tudsat-rocket/sting/README.md

EURoC Flight Computer
=====================

# Setup

Requires KiCAD version >= 6.0. To generate BOM, install the Interactive HTML BOM plugin: https://github.com/openscopeproject/InteractiveHtmlBom
