tudsat-rocket/sting/3dmodels/sma.step

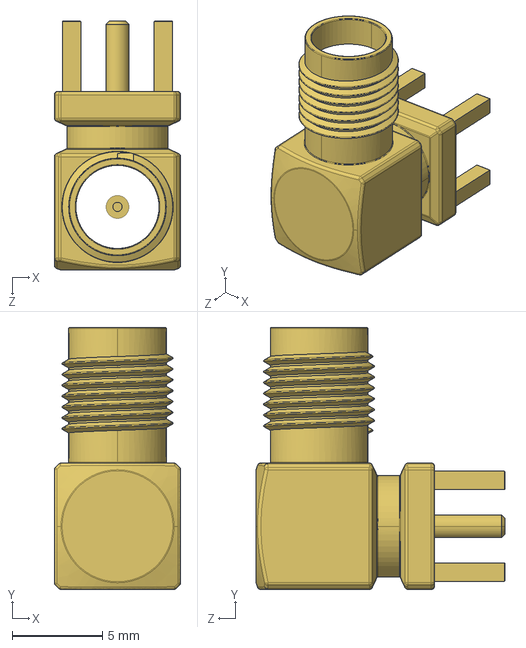
[picture p1: CAD file, 2023-01-26]
3dmodels/sma.step
7.00 x 14.5 x 13.8 mm
