tudsat-rocket/sting/3dmodels/sam_m8q.step

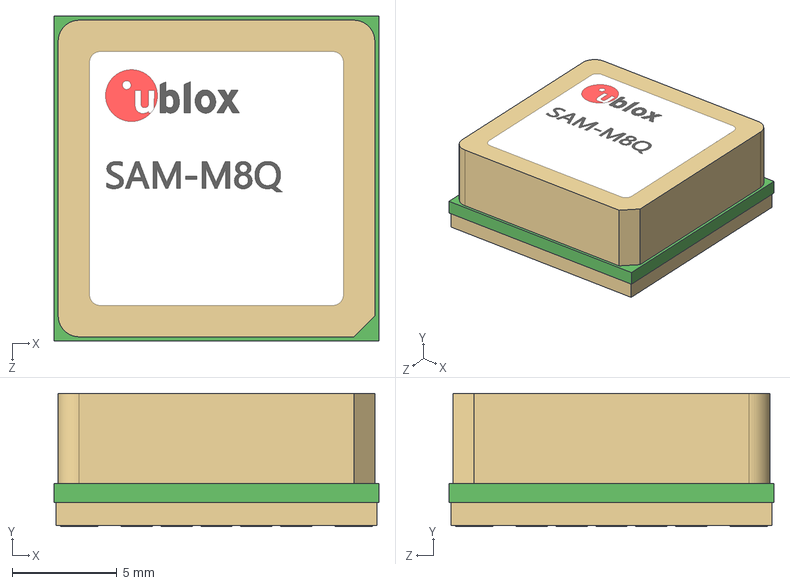
[picture p2: CAD file, 2023-01-26]
3dmodels/sam_m8q.step
15.5 x 6.35 x 15.5 mm
