tudsat-rocket/sting/3dmodels/usb_c.step

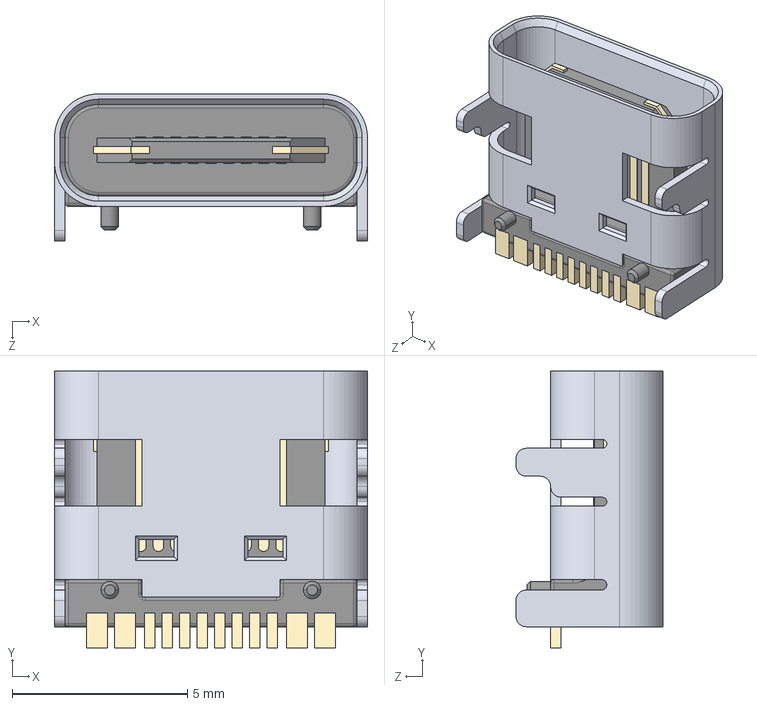
[picture p3: CAD file, 2022-07-26]
3dmodels/usb_c.step
8.94 x 7.90 x 4.20 mm
