tudsat-rocket/sting/3dmodels/ra_02.step

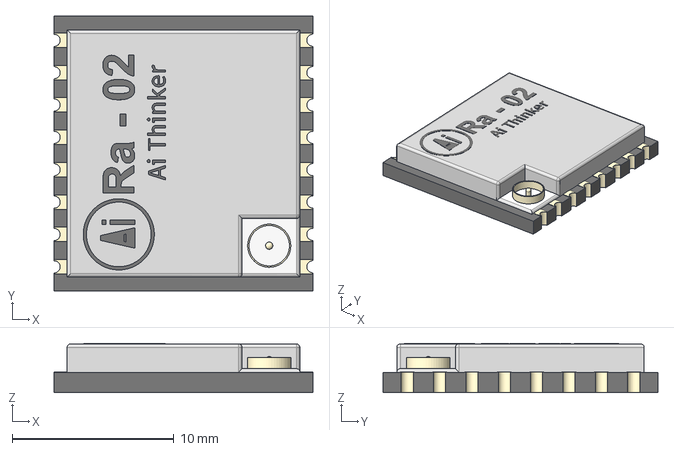
[picture p4: CAD file, 2022-07-01]
3dmodels/ra_02.step
16.0 x 17.0 x 3.03 mm
