tudsat-rocket/sting/3dmodels/EVQ-PUC02K.step

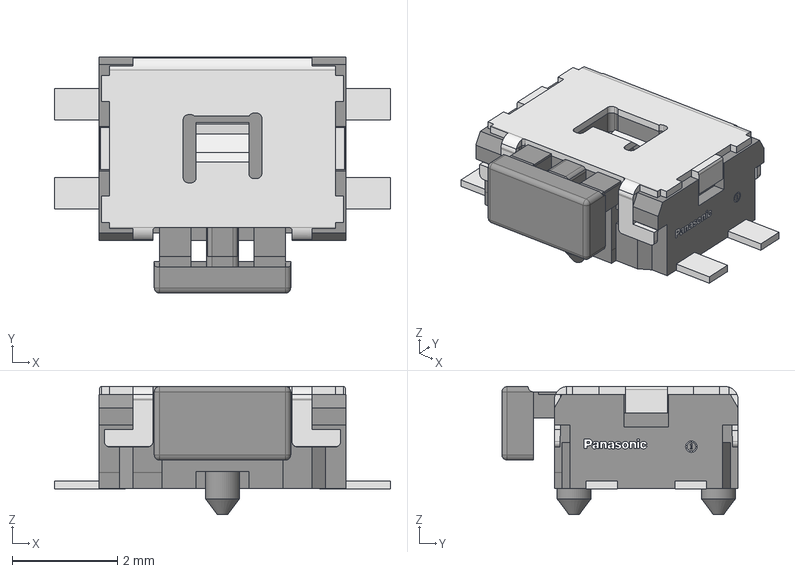
[picture p5: CAD file, 2022-07-01]
3dmodels/EVQ-PUC02K.step
6.40 x 4.50 x 2.44 mm
