tudsat-rocket/sting/3dmodels/430450400.step

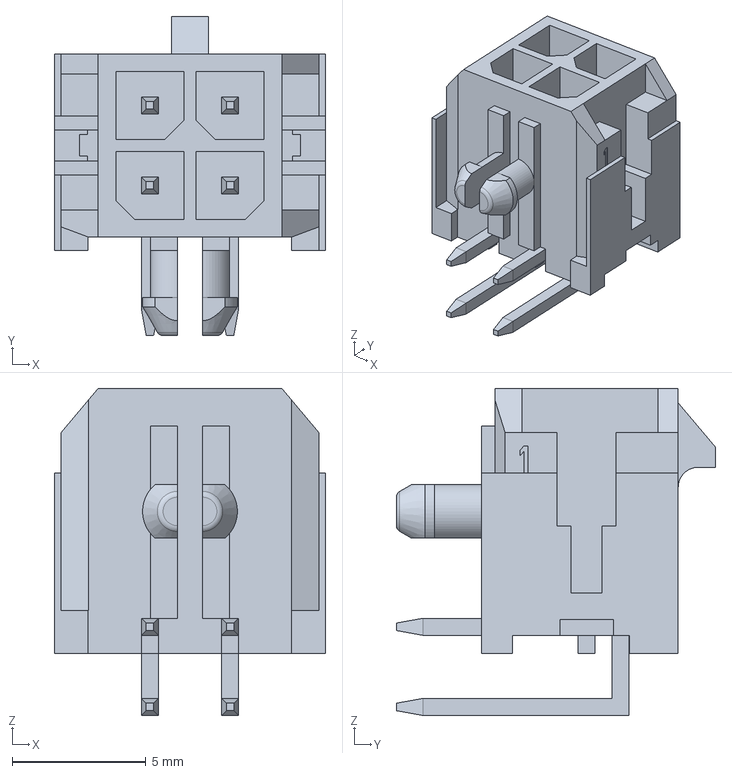
[picture p6: CAD file, 2023-01-26]
3dmodels/430450400.step
10.2 x 11.9 x 12.2 mm
