tudsat-rocket/sting/euroc_fc.kicad_pcb

## KiCad design euroc_fc.kicad_pcb (2023-02-13)

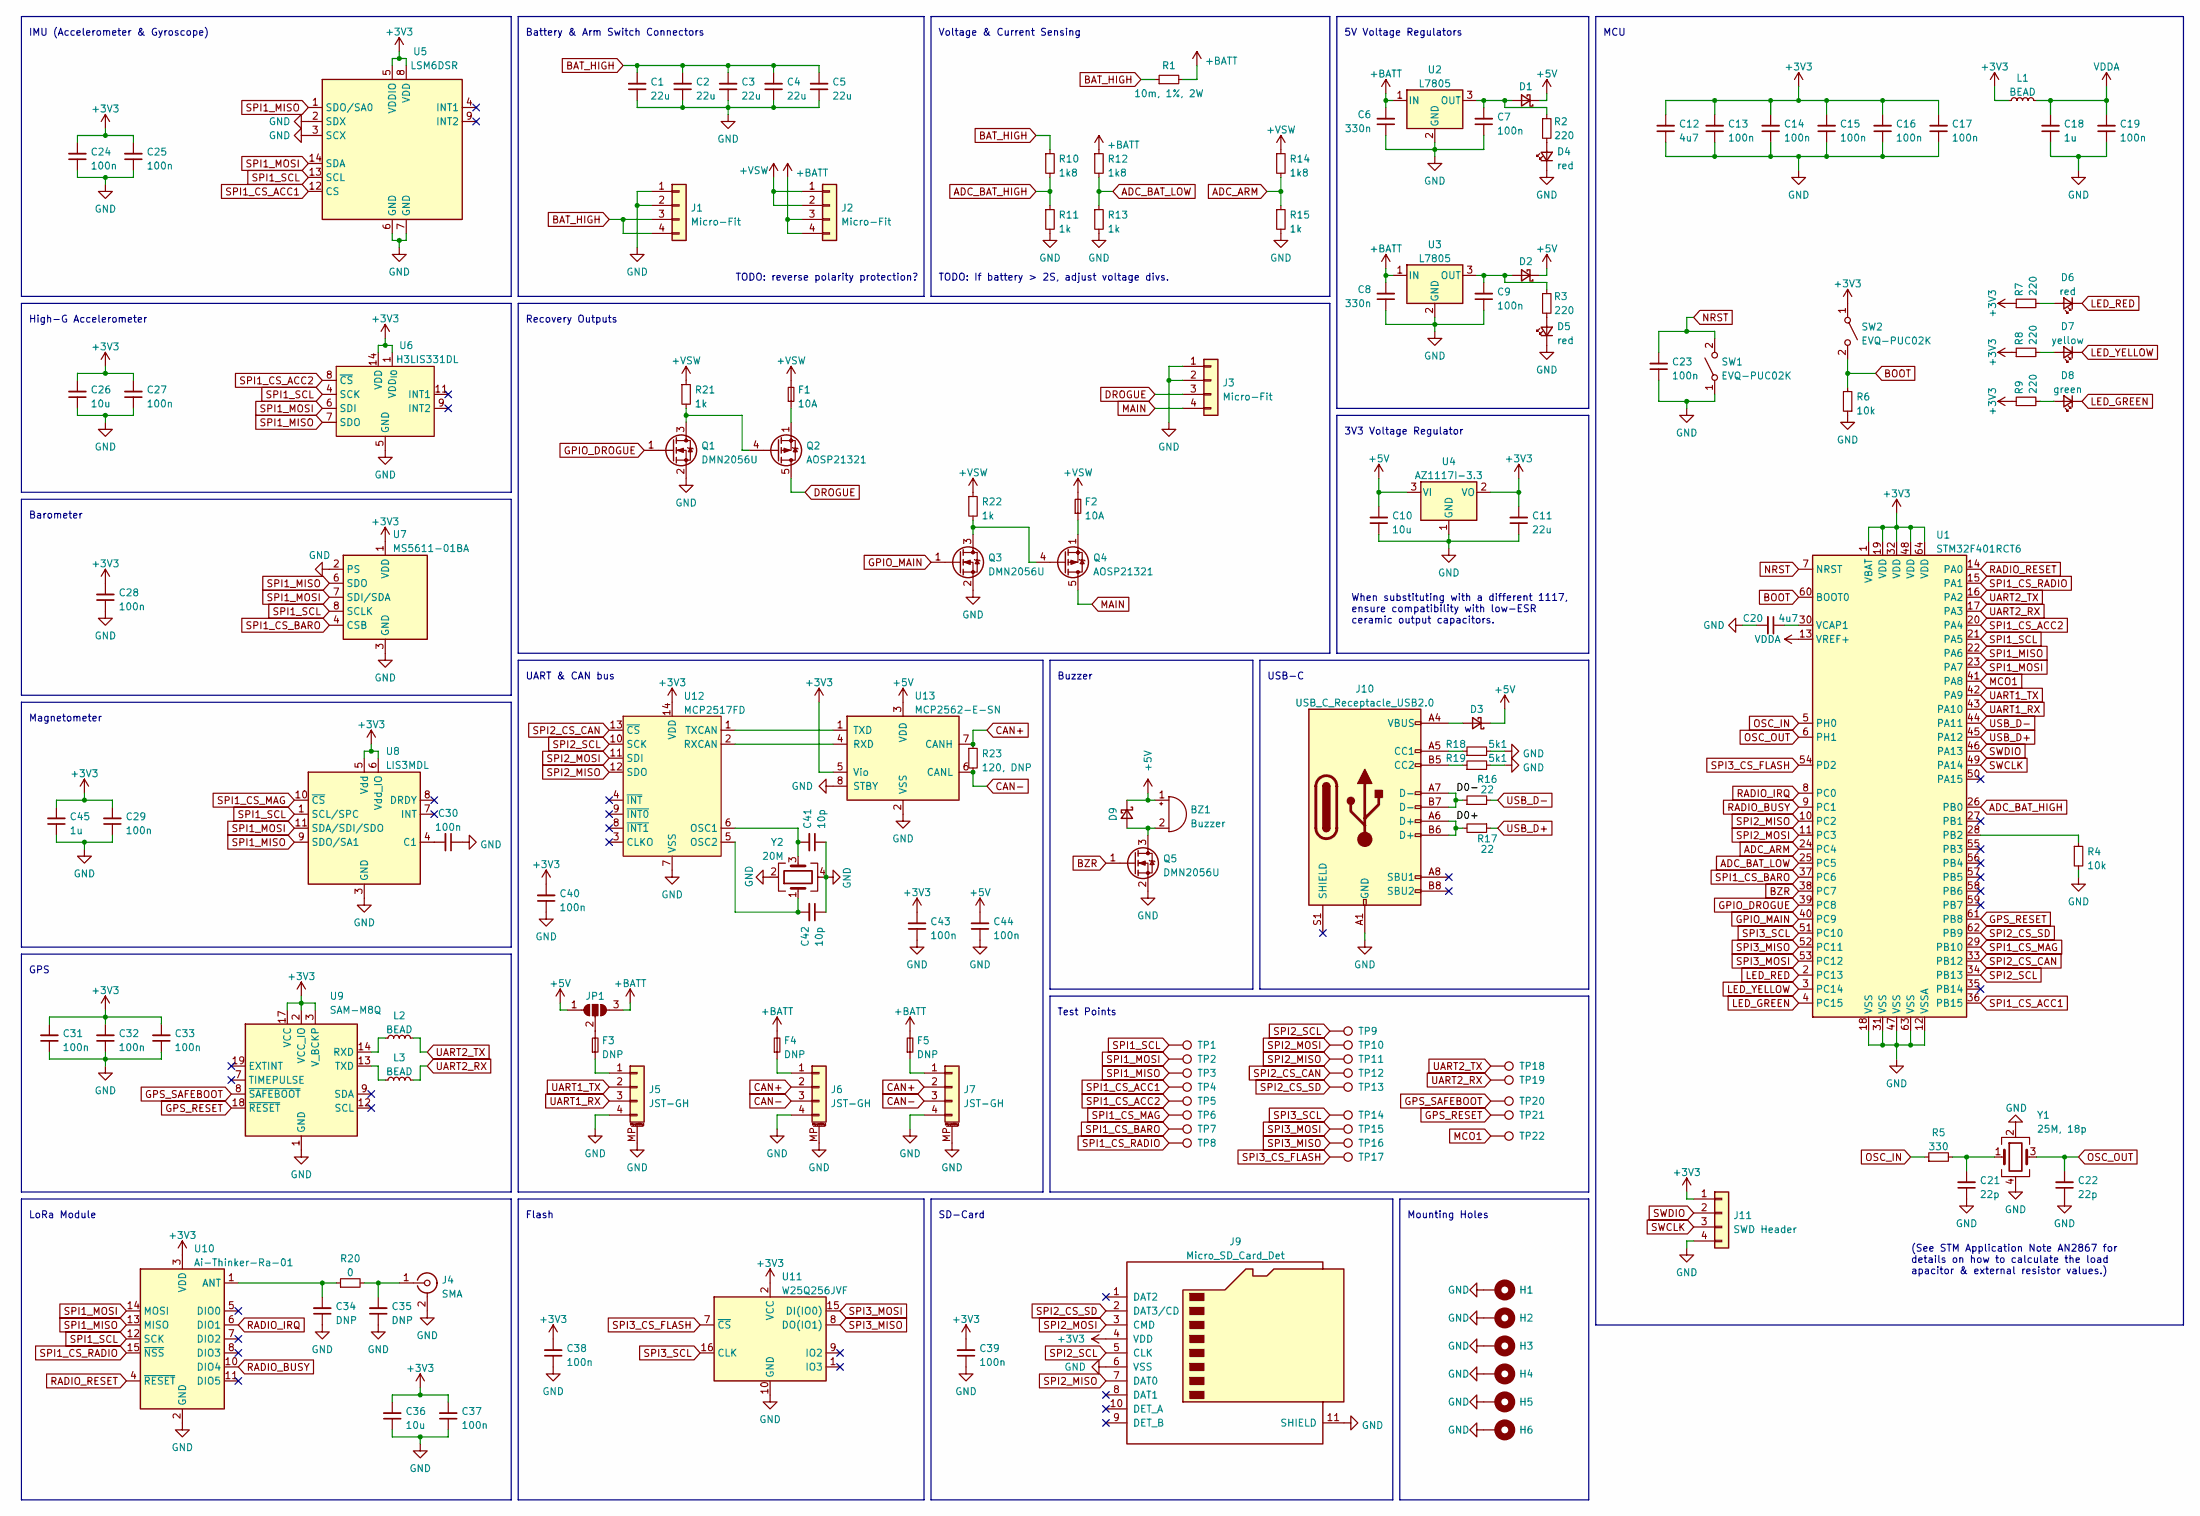
[picture p7: schematic euroc_fc.kicad_sch]

Parts:
BZ1: Buzzer; MagneticBuzzer_CUI_CMT-8504-100-SMT; Part# CMT-8504-100-SMT-TR; DigiKey# 102-CMT-8504-100-SMT-CT-ND
C1, C2, C3, C4, C5, C11: 22u; C_1206_3216Metric; Part# CL31A226KAHNNNE; LCSC# C12891
C6, C8: 330n; C_0603_1608Metric; Part# CL10B334KO8NNNC; LCSC# C159798
C7, C9, C13, C14, C15, C16, C17, C19, C23, C24, C25, C27, C28, C29, C30, C31, C32, C33, C37, C38, C39, C40, C43, C44: 100n; C_0603_1608Metric; Part# CL10B104KB8NNNC; LCSC# C1591
C10, C26, C36: 10u; C_1206_3216Metric; Part# CL31B106KAHNNNE; LCSC# C14860
C12, C20: 4u7; C_1206_3216Metric; Part# CL31B475KAHNNNE; LCSC# C1872
C18, C45: 1u; C_0805_2012Metric; Part# CL21A105KBCLNNC; LCSC# C318694
C21, C22: 22p; C_0603_1608Metric; Part# CL10C220JB8NNNC; LCSC# C1653
C34, C35: DNP; C_0603_1608Metric; Part# N/A; DigiKey# N/A
C41, C42: 10p; C_0603_1608Metric; Part# CL10C100JB8NNNC; LCSC# C1634
D1, D2, D3, D9: D_SOD-123F; Part# PMEG3020EH,115; LCSC# C167645
D4, D5, D6: red; LED_0603_1608Metric; Part# 19-213/RSC-BS2T2B/3T; LCSC# C474026
D7: yellow; LED_0603_1608Metric; Part# 19-213/Y2C-CQ2R2L/3T(CY); LCSC# C72038
D8: green; LED_0603_1608Metric; Part# 19-217/GHC-YR1S2/3T; LCSC# C72043
F1, F2: 10A; Fuse_1206_3216Metric; Part# 0501010.WR1; LCSC# C207003
F3, F4, F5: DNP; Fuse_1206_3216Metric; Part# N/A; DigiKey# N/A
H1, H2, H3, H4, H5, H6: MountingHole_Pad; MountingHole_3.2mm_M3_Pad_Via; Part# N/A; DigiKey# N/A
J1, J2, J3: Micro-Fit; Molex_Micro-Fit_3.0_43045-0400_2x02_P3.00mm_Horizontal; Part# 0430450400; LCSC# C122413
J4: SMA; SMA_Amphenol_901-143_Horizontal; Part# KH-SMA-K513-G; LCSC# C411575
J5, J6, J7: JST-GH; JST_GH_SM04B-GHS-TB_1x04-1MP_P1.25mm_Horizontal; Part# SM04B-GHS-TB; LCSC# C189895
J9: Micro_SD_Card_Det; microSD_HC_Hirose_DM3AT-SF-PEJM5; Part# DM3AT-SF-PEJM5; LCSC# C114218
J10: USB_C_Receptacle_USB2.0; USB_C_Receptacle_Palconn_UTC16-G; Part# KH-TYPE-C-16P; LCSC# C709357
J11: SWD Header; PinHeader_1x04_P2.54mm_Vertical
JP1: SolderJumper_3_Open; SolderJumper-3_P1.3mm_Open_RoundedPad1.0x1.5mm_NumberLabels; Part# N/A; DigiKey# N/A
L1, L2, L3: BEAD; L_0603_1608Metric; Part# BLM18AG601SN1D; LCSC# C19330
Q1, Q3, Q5: DMN2056U; SOT-23; Part# DMN2056U-7; LCSC# C332302
Q2, Q4: AOSP21321; SO-8_3.9x4.9mm_P1.27mm; Part# AOSP21321; LCSC# C560863
R1: 10m, 1%, 2W; R_2512_6332Metric; Part# PA2512FKE7W0R01E; LCSC# C375688
R2, R3, R7, R8, R9: 220; R_0603_1608Metric; Part# ESR03EZPJ221; LCSC# C2085669
R4, R6: 10k; R_0603_1608Metric; Part# RC0603FR-0710KL; LCSC# C98220
R5: 330; R_0603_1608Metric; Part# RC0603FR-07330RL; LCSC# C105881
R10, R12, R14: 1k8; R_0603_1608Metric; Part# RC0603FR-071K8L; LCSC# C185354
R11, R13, R15, R21, R22: 1k; R_0603_1608Metric; Part# RC0603FR-071KL; LCSC# C22548
R16, R17: 22; R_0603_1608Metric; Part# RC0603FR-0722RL; LCSC# C107701
R18, R19: 5k1; R_0603_1608Metric; Part# RC0603FR-075K1L; LCSC# C105580
R20: 0; R_0603_1608Metric; Part# RC0603FR-070RL; LCSC# C100044
R23: 120, DNP; R_0603_1608Metric; Part# RC0603FR-07120RL; LCSC# C114640
SW1, SW2: EVQ-PUC02K; Panasonic_EVQPUL_EVQPUC; Part# EVQPUC02K; LCSC# C79174
TP1, TP2, TP3, TP4, TP5, TP6, TP7, TP8, TP9, TP10, TP11, TP12, TP13, TP14, TP15, TP16, TP17, TP18, TP19, TP20, TP21, TP22: TestPoint; TestPoint_Pad_D2.0mm; Part# N/A; DigiKey# N/A
U1: STM32F401RCT6; LQFP-64_10x10mm_P0.5mm; Part# STM32F401RCT6; LCSC# C74524
U2, U3: L7805; TO-252-2; Part# L7805CDT-TR; LCSC# C310413
U4: AZ1117I-3.3; SOT-223-3_TabPin2; Part# AZ1117CH-3.3TRG1; LCSC# C92102
U5: LSM6DSR; LGA-14_3x2.5mm_P0.5mm_LayoutBorder3x4y; Part# LSM6DSRTR; LCSC# C784817
U6: H3LIS331DL; LGA-16_3x3mm_P0.5mm_LayoutBorder3x5y; Part# H3LIS331DLTR; DigiKey# 497-13903-1-ND
U7: MS5611-01BA; LGA-8_3x5mm_P1.25mm; Part# MS561101BA03-50; DigiKey# 223-1622-1-ND
U8: LIS3MDL; LGA-12_2x2mm_P0.5mm; Part# LIS3MDLTR; DigiKey# 497-13892-1-ND
U9: SAM-M8Q; ublox_SAM-M8Q; Part# SAM-M8Q-0-10; DigiKey# 672-1054-1-ND
U10: Ai-Thinker-Ra-01; Ai-Thinker-Ra-01-LoRa; Part# Ra-01SC; LCSC# C2830749
U11: W25Q256JVF; SOIC-16W_7.5x10.3mm_P1.27mm; Part# W25Q256JVFIQ; DigiKey# W25Q256JVFIQ-ND
U12: MCP2517FD; SOIC-14_3.9x8.7mm_P1.27mm; Part# MCP2517FDT-H/SL; DigiKey# MCP2517FDT-H/SLCT-ND
U13: MCP2562-E-SN; SOIC-8_3.9x4.9mm_P1.27mm; Part# MCP2562-H/SN; DigiKey# MCP2562-H/SN
Y1: 25M, 18p; Oscillator_SMD_SeikoEpson_SG210-4Pin_2.5x2.0mm; Part# Q24FA20H0039000; LCSC# C255956
Y2: 20M; Crystal_SMD_2016-4Pin_2.0x1.6mm; Part# Q22FA12800335; LCSC# C255878

Connections:
+3V3: C11.2, C12.2, C13.2, C14.2, C15.2, C16.2, C17.2, C24.2, C25.2, C26.2, C27.2, C28.2, C29.2, C31.2, C32.2, C33.2, C36.2, C37.2, C38.2, C39.2, C40.2, C43.2, C45.2, J9.4 (VDD), J11.1, L1.1, R7.1, R8.1, R9.1, SW2.1 (A), U1.1 (VBAT), U1.19 (VDD), U1.32 (VDD), U1.48 (VDD), U1.64 (VDD), U4.2 (VO), U5.5 (VDDIO), U5.8 (VDD), U6.1 (VDD_{IO}), U6.14 (VDD), U6.15 (reserved), U7.1 (VDD), U8.5 (Vdd), U8.6 (Vdd_IO), U9.2 (VCC_IO), U9.3 (V_BCKP), U9.17 (VCC), U10.3 (VDD), U11.2 (VCC), U12.14 (VDD), U13.5 (Vio)
+5V: BZ1.1 (-), C10.2, C44.2, D1.1 (K), D2.1 (K), D3.1 (K), D9.1 (K), JP1.1 (A), U4.3 (VI), U13.3 (VDD)
+BATT: C6.2, C8.2, F4.2, F5.2, J2.3, J2.4, JP1.3 (B), R1.2, R12.1, U2.1 (IN), U3.1 (IN)
+VSW: F1.2, F2.2, J2.1, J2.2, R14.1, R21.1, R22.1
/D0+: J10.A6 (D+), J10.B6 (D+), R17.2
/D0-: J10.A7 (D-), J10.B7 (D-), R16.1
ADC_ARM: R14.2, R15.1, U1.24 (PC4)
ADC_BAT_HIGH: R10.2, R11.1, U1.26 (PB0)
ADC_BAT_LOW: R12.2, R13.1, U1.25 (PC5)
BAT_HIGH: C1.2, C2.2, C3.2, C4.2, C5.2, J1.3, J1.4, R1.1, R10.1
BOOT: R6.2, SW2.2 (B), U1.60 (BOOT0)
BZR: Q5.1 (G), U1.38 (PC7)
CAN+: J6.2, J7.2, R23.1, U13.7 (CANH)
CAN-: J6.3, J7.3, R23.2, U13.6 (CANL)
DROGUE: J3.3, Q2.5 (D), Q2.6 (D), Q2.7 (D), Q2.8 (D)
GND: C1.1, C2.1, C3.1, C4.1, C5.1, C6.1, C7.1, C8.1, C9.1, C10.1, C11.1, C12.1, C13.1, C14.1, C15.1, C16.1, C17.1, C18.1, C19.1, C20.2, C21.1, C22.1, C23.1, C24.1, C25.1, C26.1, C27.1, C28.1, C29.1, C30.1, C31.1, C32.1, C33.1, C34.1, C35.1, C36.1, C37.1, C38.1, C39.1, C40.1, C41.1, C42.1, C43.1, C44.1, C45.1, D4.1 (K), D5.1 (K), H1.1, H2.1, H3.1, H4.1, H5.1, H6.1, J1.1, J1.2, J3.1, J3.2, J4.2 (Ext), J5.4, J5.MP (MountPin), J6.4, J6.MP (MountPin), J7.4, J7.MP (MountPin), J9.6 (VSS), J9.11 (SHIELD), J10.A1 (GND), J10.A12 (GND), J10.B1 (GND), J10.B12 (GND), J11.4, Q1.2 (S), Q3.2 (S), Q5.2 (S), R4.2, R6.1, R11.2, R13.2, R15.2, R18.2, R19.2, SW1.1 (A), U1.12 (VSSA), U1.18 (VSS), U1.31 (VSS), U1.47 (VSS), U1.63 (VSS), U2.2 (GND), U3.2 (GND), U4.1 (GND), U5.2 (SDX), U5.3 (SCX), U5.6 (GND), U5.7 (GND), U6.5 (GND), U6.10 (reserved), U6.12 (GND), U6.13 (GND), U6.16 (GND), U7.2 (PS), U7.3 (GND), U8.2 (GND), U8.3 (GND), U8.12 (GND), U9.1 (GND), U9.4 (GND), U9.5 (GND), U9.6 (GND), U9.10 (GND), U9.11 (GND), U9.15 (GND), U9.16 (GND), U9.20 (GND), U10.2 (GND), U10.9 (GND), U10.16 (GND), U11.10 (GND), U12.7 (VSS), U13.2 (VSS), U13.8 (STBY), Y1.2, Y1.4, Y2.2, Y2.4
GPIO_DROGUE: Q1.1 (G), U1.39 (PC8)
GPIO_MAIN: Q3.1 (G), U1.40 (PC9)
GPS_RESET: TP21.1, U1.61 (PB8), U9.18 (~RESET)
GPS_SAFEBOOT: TP20.1, U9.8 (~SAFEBOOT)
LED_GREEN: D8.1 (K), U1.4 (PC15)
LED_RED: D6.1 (K), U1.2 (PC13)
LED_YELLOW: D7.1 (K), U1.3 (PC14)
MAIN: J3.4, Q4.5 (D), Q4.6 (D), Q4.7 (D), Q4.8 (D)
MCO1: TP22.1, U1.41 (PA8)
NRST: C23.2, SW1.2 (B), U1.7 (NRST)
unnamed: BZ1.2 (+), D9.2 (A), Q5.3 (D)
unnamed: C7.2, D1.2 (A), R2.1, U2.3 (OUT)
unnamed: C9.2, D2.2 (A), R3.1, U3.3 (OUT)
unnamed: C20.1, U1.30 (VCAP1)
unnamed: C21.2, R5.2, Y1.1
unnamed: C30.2, U8.4 (C1)
unnamed: C34.2, R20.1, U10.1 (ANT)
unnamed: C35.2, J4.1 (In), R20.2
unnamed: C41.2, U12.6 (OSC1), Y2.3
unnamed: C42.2, U12.5 (OSC2), Y2.1
unnamed: D3.2 (A), J10.A4 (VBUS), J10.A9 (VBUS), J10.B4 (VBUS), J10.B9 (VBUS)
unnamed: D4.2 (A), R2.2
unnamed: D5.2 (A), R3.2
unnamed: D6.2 (A), R7.2
unnamed: D7.2 (A), R8.2
unnamed: D8.2 (A), R9.2
unnamed: F1.1, Q2.1 (S), Q2.2 (S), Q2.3 (S)
unnamed: F2.1, Q4.1 (S), Q4.2 (S), Q4.3 (S)
unnamed: F3.1, J5.1
unnamed: F3.2, JP1.2 (C)
unnamed: F4.1, J6.1
unnamed: F5.1, J7.1
unnamed: J10.A5 (CC1), R18.1
unnamed: J10.B5 (CC2), R19.1
unnamed: L2.1, U9.14 (RXD)
unnamed: L3.1, U9.13 (TXD)
unnamed: Q1.3 (D), Q2.4 (G), R21.2
unnamed: Q3.3 (D), Q4.4 (G), R22.2
unnamed: R4.1, U1.28 (PB2)
unnamed: U12.1 (TXCAN), U13.1 (TXD)
unnamed: U12.2 (RXCAN), U13.4 (RXD)
OSC_IN: R5.1, U1.5 (PH0)
OSC_OUT: C22.2, U1.6 (PH1), Y1.3
RADIO_BUSY: U1.9 (PC1), U10.10 (DIO4)
RADIO_IRQ: U1.8 (PC0), U10.6 (DIO1)
RADIO_RESET: U1.14 (PA0), U10.4 (~RESET)
SPI1_CS_ACC1: TP4.1, U1.36 (PB15), U5.12 (CS)
SPI1_CS_ACC2: TP5.1, U1.20 (PA4), U6.8 (~CS)
SPI1_CS_BARO: TP7.1, U1.37 (PC6), U7.4 (CSB), U7.5 (CSB)
SPI1_CS_MAG: TP6.1, U1.29 (PB10), U8.10 (~CS)
SPI1_CS_RADIO: TP8.1, U1.15 (PA1), U10.15 (~NSS)
SPI1_MISO: TP3.1, U1.22 (PA6), U5.1 (SDO/SA0), U6.7 (SDO), U7.6 (SDO), U8.9 (SDO/SA1), U10.13 (MISO)
SPI1_MOSI: TP2.1, U1.23 (PA7), U5.14 (SDA), U6.6 (SDI), U7.7 (SDI/SDA), U8.11 (SDA/SDI/SDO), U10.14 (MOSI)
SPI1_SCL: TP1.1, U1.21 (PA5), U5.13 (SCL), U6.4 (SCK), U7.8 (SCLK), U8.1 (SCL/SPC), U10.12 (SCK)
SPI2_CS_CAN: TP12.1, U1.33 (PB12), U12.13 (~CS)
SPI2_CS_SD: J9.2 (DAT3/CD), TP13.1, U1.62 (PB9)
SPI2_MISO: J9.7 (DAT0), TP11.1, U1.10 (PC2), U12.12 (SDO)
SPI2_MOSI: J9.3 (CMD), TP10.1, U1.11 (PC3), U12.11 (SDI)
SPI2_SCL: J9.5 (CLK), TP9.1, U1.34 (PB13), U12.10 (SCK)
SPI3_CS_FLASH: TP17.1, U1.54 (PD2), U11.7 (~CS)
SPI3_MISO: TP16.1, U1.52 (PC11), U11.8 (DO(IO1))
SPI3_MOSI: TP15.1, U1.53 (PC12), U11.15 (DI(IO0))
SPI3_SCL: TP14.1, U1.51 (PC10), U11.16 (CLK)
SWCLK: J11.3, U1.49 (PA14)
SWDIO: J11.2, U1.46 (PA13)
UART1_RX: J5.3, U1.43 (PA10)
UART1_TX: J5.2, U1.42 (PA9)
UART2_RX: L3.2, TP19.1, U1.17 (PA3)
UART2_TX: L2.2, TP18.1, U1.16 (PA2)
USB_D+: R17.1, U1.45 (PA12)
USB_D-: R16.2, U1.44 (PA11)
VDDA: C18.2, C19.2, L1.2, U1.13 (VREF+)

Notes on the sheet:
SD-Card
High-G Accelerometer
Magnetometer
GPS
Recovery Outputs
USB-C
Mounting Holes
Battery & Arm Switch Connectors
When substituting with a different 1117, ensure compatibility with low-ESR ceramic output capacitors.
Voltage & Current Sensing
Barometer
Flash
IMU (Accelerometer & Gyroscope)
LoRa Module
Test Points
Buzzer
TODO: reverse polarity protection?
TODO: If battery > 2S, adjust voltage divs.
UART & CAN bus
(See STM Application Note AN2867 for details on how to calculate the load apacitor & external resistor values.)
5V Voltage Regulators
MCU
3V3 Voltage Regulator

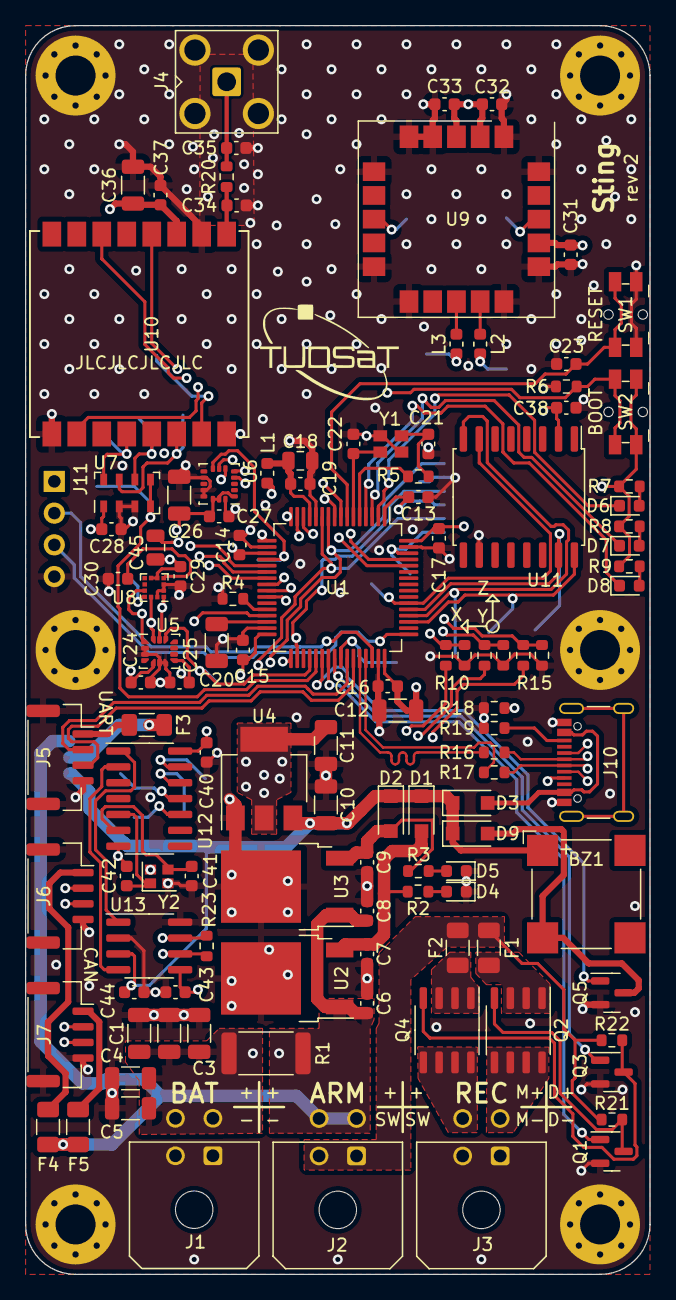
[picture p8: board euroc_fc.kicad_pcb from above]

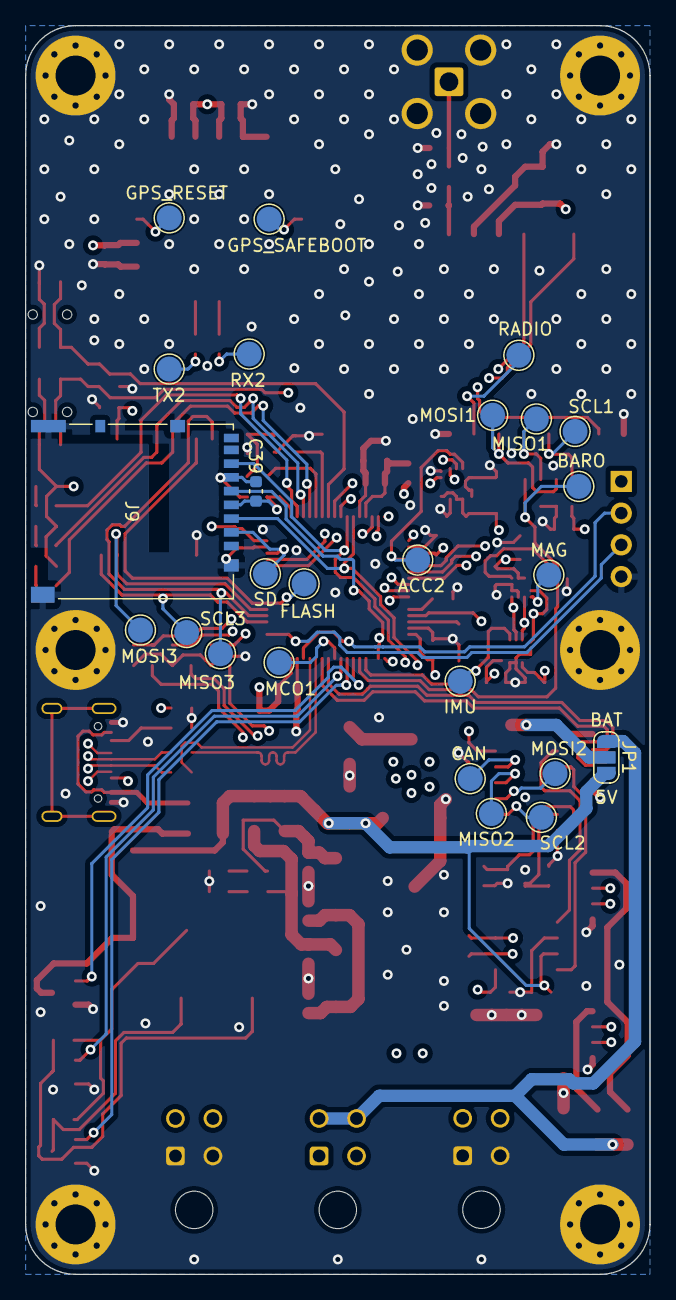
[picture p9: board euroc_fc.kicad_pcb from below]

Board: 4 copper layers, 50.0 x 100.0 mm, 147 parts (25 on the bottom side), 88 nets.
