tudsat-rocket/sting/(commit log)

2022-07-01 Update part selection, complete BOM
    - Voltage divider reduced to 1k / (1k + 1k8)
    - Diode changed to onsemi SS26FL (higher current capacity)
    - N-Ch. MOSFET changed to DMN2056U (official successor)
    - uSD holder changed to Hirose DM3AT (push-push)
    - Vendor and Datasheet fields filled out for (almost) all components
    [euroc_fc.kicad_pcb, euroc_fc.kicad_sch]
2022-07-09 Tweak LoRa trans line impedance, power planes
    [euroc_fc.kicad_pcb, euroc_fc.kicad_sch]
2022-07-09 Tweak via grouping for power planes
    [euroc_fc.kicad_pcb]
2022-07-09 Add flyback diode for buzzer
    [euroc_fc.kicad_pcb, euroc_fc.kicad_sch]
2022-07-09 Fix ADC pin assignment, rename nets
    [euroc_fc.kicad_pcb, euroc_fc.kicad_sch]
2022-07-10 Place additional test points
    [euroc_fc.kicad_pcb, euroc_fc.kicad_sch]
2022-07-10 Tweak test points
    [euroc_fc.kicad_pcb]
2022-07-12 Remove various TODOs
    [euroc_fc.kicad_pcb, euroc_fc.kicad_sch]
2022-07-14 Relayout the board, optimize return current paths
    - Board stackup changed to Signal, Ground, Signal+Power, Signal+Ground
    - L2 is now uninterrupted ground plane
    - Addition of a proper SWD header (SWD test points removed)
    - Moved all auxilliary connectors to the left
    - Optimized paths for high-speed signals (SPI, SWD, USB)
    - All SPI1 devices grouped on the left, SPI2 & 3 on the right, meaning
    shorter SPI1 bus
    - No crossing of high speed signals on L1&2 or L3&4
    - Addition of an indicator for coordinate system
    [euroc_fc.kicad_pcb, euroc_fc.kicad_sch]
2022-07-26 Adjust cap value notation
    [euroc_fc.kicad_pcb, euroc_fc.kicad_sch]
2022-07-26 Restructure BOM
    [euroc_fc.kicad_sch]
2022-07-26 Replace crystal oscillator part
    [euroc_fc.kicad_pcb, euroc_fc.kicad_sch]
2022-07-26 Replace USB connector
    New part is cheaper, smaller, easier to solder and avilable at LCSC.
    Also, don't ground the USB shield anymore.
    [euroc_fc.kicad_pcb, euroc_fc.kicad_sch, usb_c.step]
2022-07-26 Substitute various parts with LCSC alternatives
    [euroc_fc.kicad_pcb, euroc_fc.kicad_sch]
2022-07-26 Update BOM
2022-09-08 Fix MCO typo
    [euroc_fc.kicad_pcb]
2023-01-26 Add CAN bus controller, transceiver & connectors
    - Accelerometer 2 is removed from SPI for now, to be replaced
    - Flash moved from SPI2 to SPI3
    - SPI2 is used for CAN bus (also SD Card)
    - ADC voltage dividers moved to right of PCB, IO connectors removed to
    make room
    - Minor pinout changes.
    [euroc_fc.kicad_pcb, euroc_fc.kicad_sch]
2023-01-26 Replace backup acc., magnetometer
    [euroc_fc.kicad_pcb, euroc_fc.kicad_sch]
2023-01-26 Update 3dmodels to step
    [430450400.step, euroc_fc.kicad_pcb, sam_m8q.step, sma.step]
2023-02-12 Finish rev. 2
    [euroc_fc.kicad_pcb, euroc_fc.kicad_sch]
2023-02-13 Update BOM for rev. 2
    [euroc_fc.kicad_pcb, euroc_fc.kicad_sch]
